rajratnapatil9/Adaptive-Headlight-system-for-Automobile-/Setup.JPG

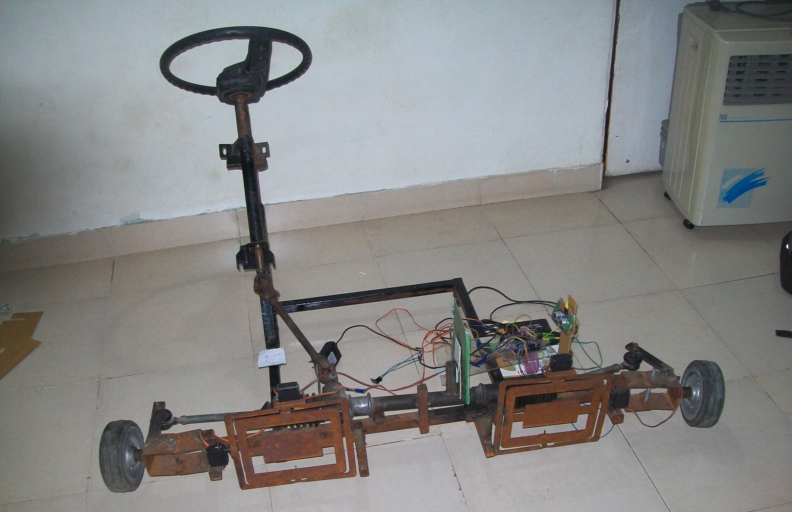
Setup.JPG
