rajratnapatil9/Adaptive-Headlight-system-for-Automobile-/Adaptive Headlight System for Automobiles.pdf

## BE PROJECT

## ADAPTIVE HEADLIGHT SYSTEM FOR AUTOMOBILES

By
RAJRATNA PATIL | (B120310951)
OMKAR PAWAR | (B120310958)
ABHISHEK PATHAK | (B120310958)

# Need of Project

- In 2014 out of 6,98,451 people from accident 4,882 people dead.
- Night accidents-Poor Road visibility on Curved path - 25%
Poor Road visibility due to slope of driving terrain - 30% Other reasons – 45%

## AIM OF THE PROJECT

## This project is aimed at developing an adaptive headlight system for automobiles that automates the movement of headlights

without manual switching.

# Project objectives

- To enhance existing functionality of headlights.
- Improve visibility on turns.
- Decrease number of night accidents.

## - Increase safety for drivers and pedestrians

HORIZONTAL
SWIVELING
(Yawing OF HEADLIGHT)

1] Horizontal Swiveling Is Used To
Turn The Headlight In Horizontal Plane.

2] It Rotates In The Direction Proportionate To The Wheel While Taking Turn.

1] Vertical Swiveling Is Used To Compensate The Pitching Of Car ,During Driving Through Steep Slope.

2] It Helps To Focus The Light At The Required Path.

VERTICAL
SWIVELING
(Pitching OF HEADLIGHT)

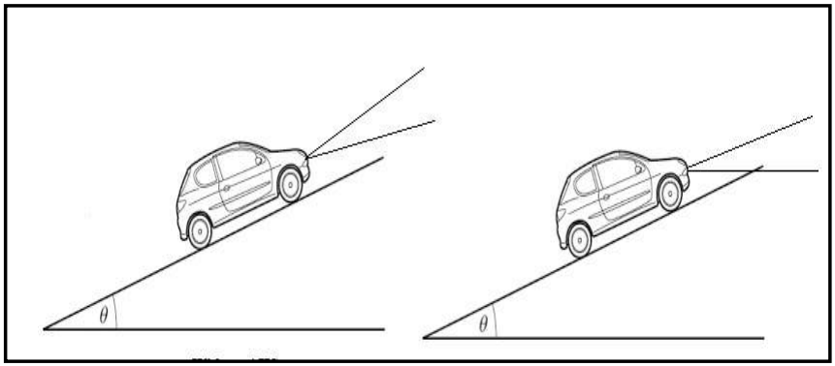
[picture p2: figure]
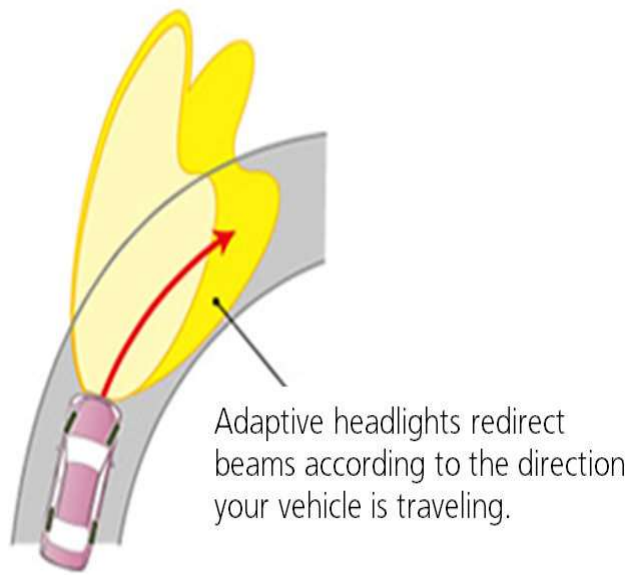
[picture p3: figure]

Without AHS | With AHS

# LOCK TO LOCK POSITION

### Center to Right/Left – 1.5 turns

### (540 degrees of steering wheel motion)

### Lock to Lock (Extreme Right to Extreme Left)

### 3turns (1080 degrees of steering wheel motion)

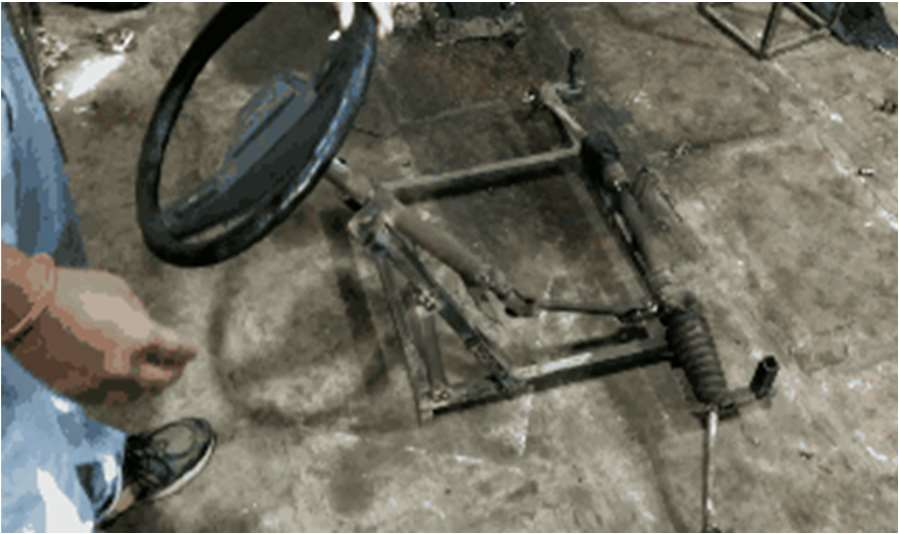
[picture p4: figure]

### Center to Right/ Left caster wheel

Angle- 45 degrees

### Lock to lock caster wheel Angle- 90 degrees

# Parts of Adaptive Headlight System

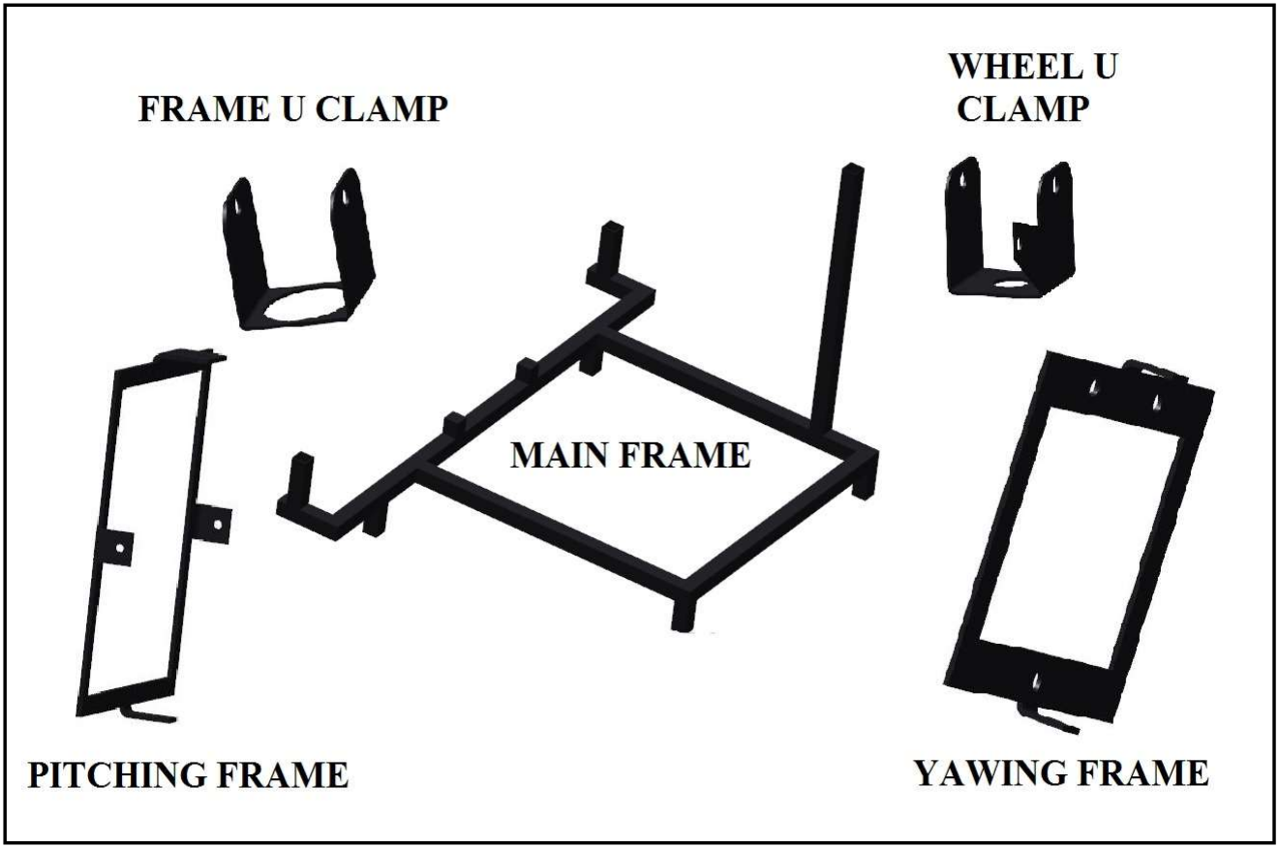
[picture p5: figure]

## CALCULATIONS

- The steering wheel has to rotate THREE complete revolutions
to move the caster wheel from lock-to-lock position . Thus 3 x 360 = 1080 degrees to move from lock-to-lock position

Thus 1.5 x 360 = 540 degrees to move from Center to Right/ Left position

Center to Right/ Left caster wheel Angle- 45 degrees
Therefore

S.R = 540/45 = 12:1

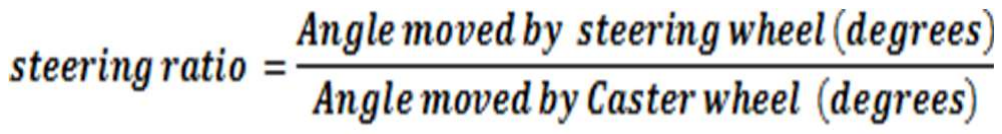
[picture p6: figure]

Specifications of rack and pinion assembly –

Number of teeth on rack = 27
Number of teeth on pinion = 18
Module = 1.5 mm
Pressure angle = 20 degrees Rack length = 127 mm

## CALCULATIONS

Parameter | Calculated Value
Area of Pitching Frame | (20.5 x 24.5) – (17.8 x 21.8) = 114.21 cm²
Area of Yawing Frame | {[(21 x 17.5) – (17 x 13.5)] + (2 x 2.5 x 2.1) + (12 x 6.5)} = 226.5 cm²
Total Area | 114.21 + 226.5 = 340.71 cm²
Total Volume | 340.71 x 0.2 = 68.142 cm³
Mass of Pitching and Yawing Frame | 7.85 x 68.142 = 511.065 gram
Total mass | 511.065 + 55 = approx 566 gram
Moment | (566 x sin20⁰ ) x (10.25) = 1984.22 gram-cm
Actual moment | 1984.22 x 1.5 = 2976.344 gram-cm
- Selecting motor such that Restoring Torque > Moment
As 9.40 kg-cm > 2.97 kg-cm
Therefore ,we selected Motor MG995 as it is best suited for our project.

# Manufacturing Stages

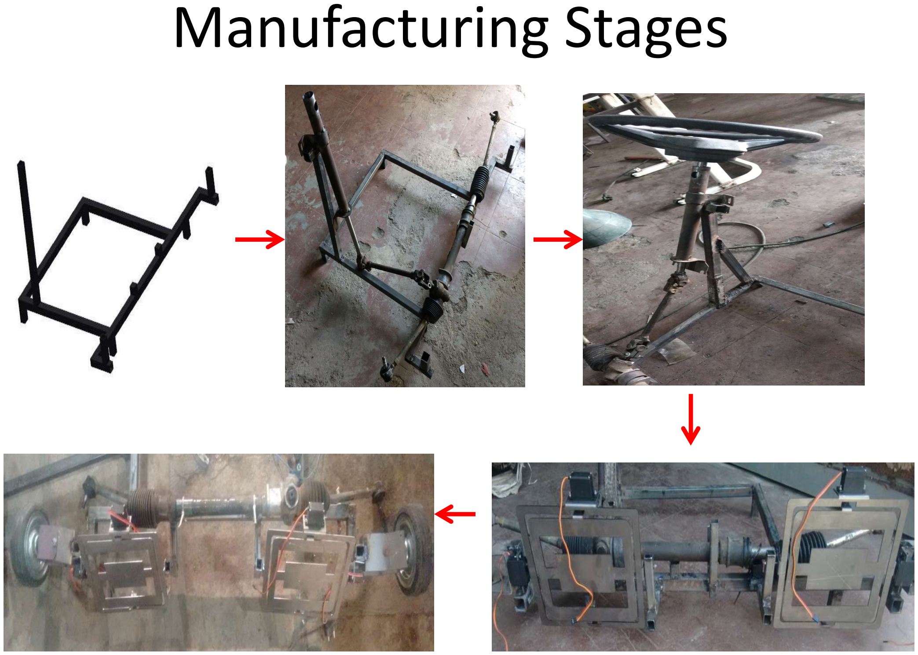
[picture p7: page 10]

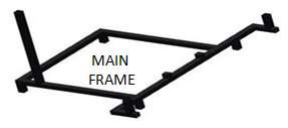
[picture p8: figure]

Main Frame

- Dimensions- 900 x 600 x 525 mm³
- Material- M.S (25 x 25 mm²
) • | Manufacturing processes- | Saw-cutting
- Electric-arc Welding(230 V)

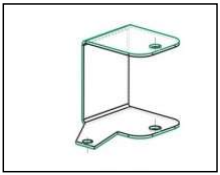
[picture p9: figure]

Wheel U-Clamp

- Dimensions- 68 X 60 X 64 mm³
- Material- M.S
- | Manufacturing processes- | Laser-cutting
- Bending
- Drilling

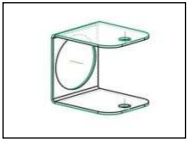
[picture p10: figure]

Frame U-Clamp

- Dimensions- 68 X 60 X 64 mm³
- Material- M.S
- | Manufacturing processes- | Laser-cutting
- Bending
- Drilling

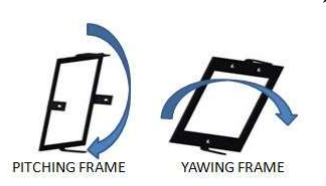
[picture p11: figure]

Pitching frame • | Dimensions- 205 x 245 x 32 • | Material- M.S • | Manufacturing processes- | Laser-cutting Bending

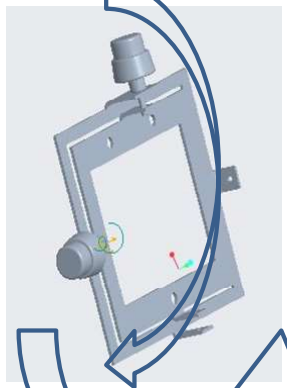
[picture p12: figure]

Yawing frame • | Dimensions- 210 x 175 x 27 • | Material- M.S • | Manufacturing processes- Laser-cutting Bending

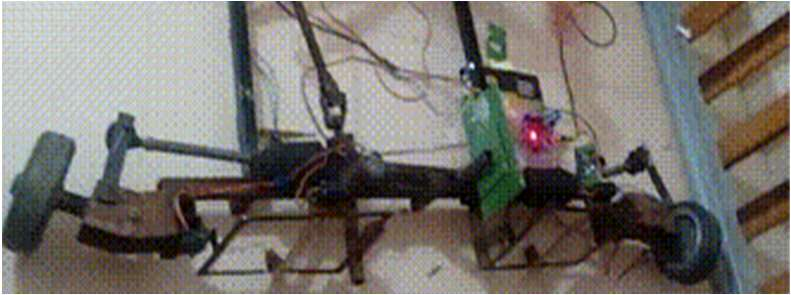
[picture p13: figure]
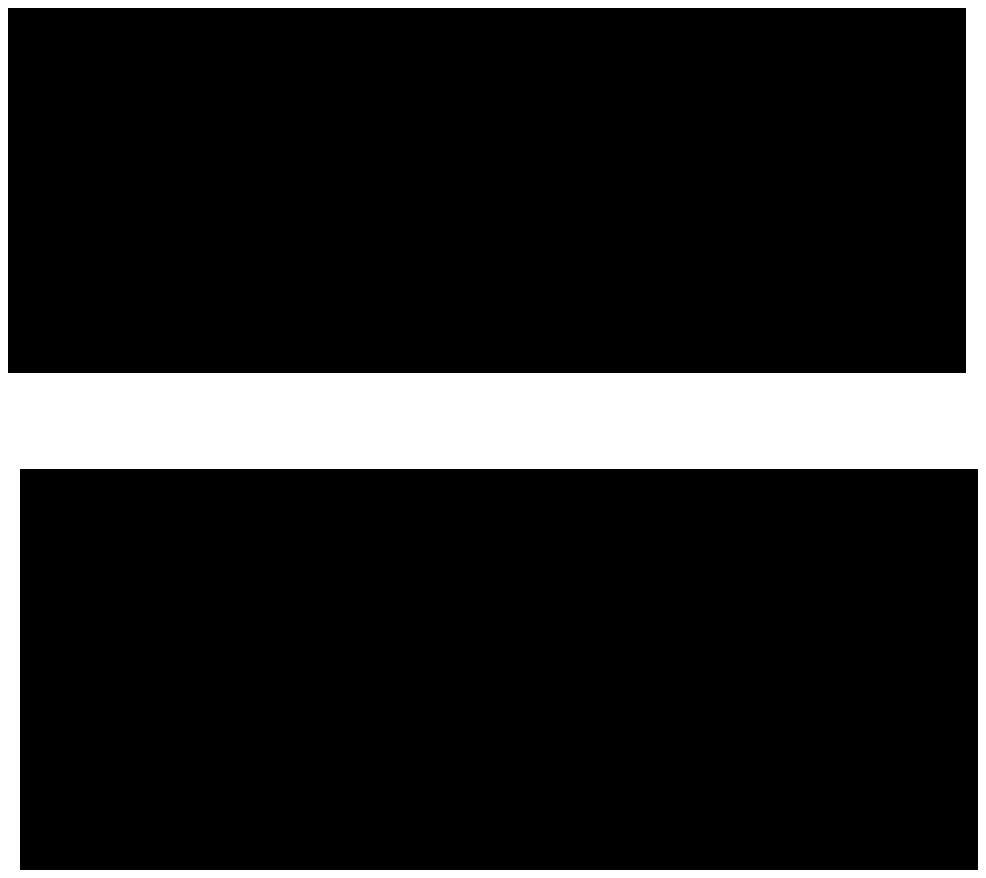
[picture p14: page 13]

## STEERING WHEEL &

STEERING COLUMN ASSEMBLY.

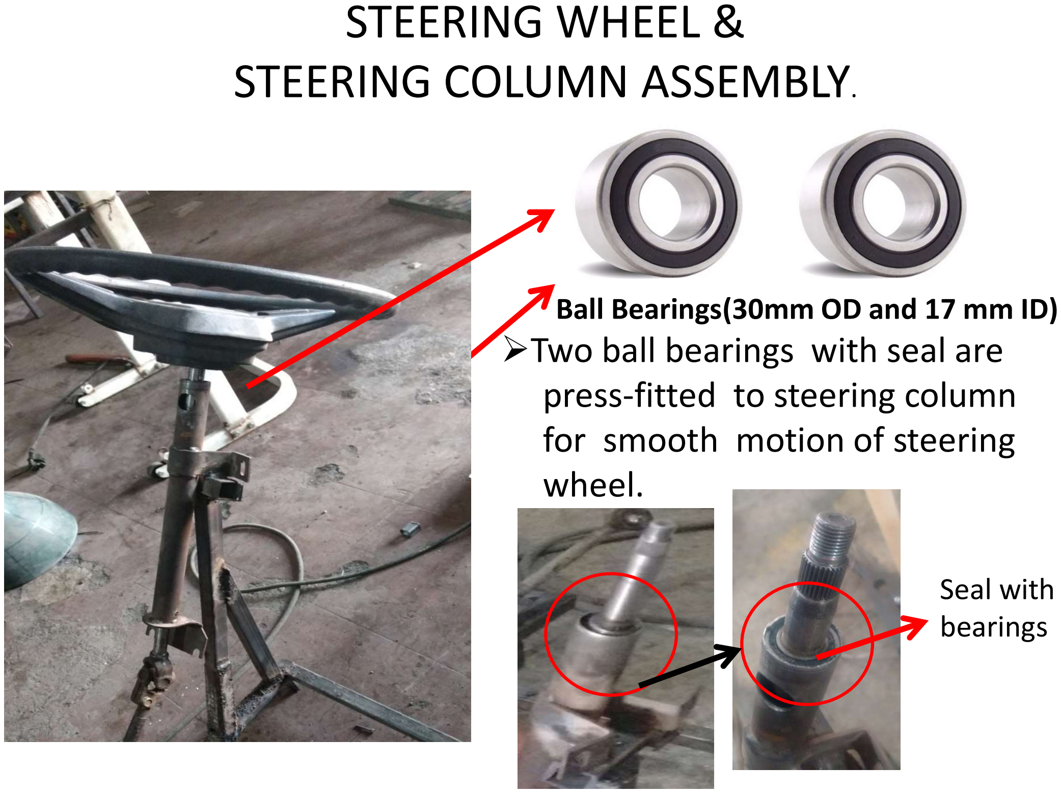
[picture p15: page 14]

Ball Bearings(30mm OD and 17 mm ID)

### Two ball bearings with seal are press-fitted to steering column for smooth motion of steering

wheel.

Seal with
bearings

# Procured Parts

Caster Wheel

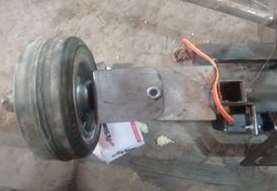
[picture p16: figure]

Dimensions

### 15 cm Diameter 10 cm axle length

- 3 cm axle diameter

Rack and Pinion Mechanism

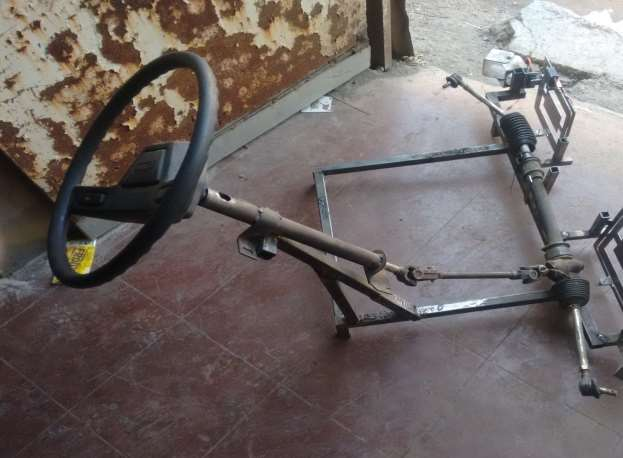
[picture p17: figure]

Specifications | Dimensions
Number of teeth on rack | 27
Number of teeth on pinion | 18
Module | 1.5 mm
Pressure angle | 20 ⁰
Rack length | 127 mm

Wheel U Clamp and Frame U Clamp with Caster Wheel

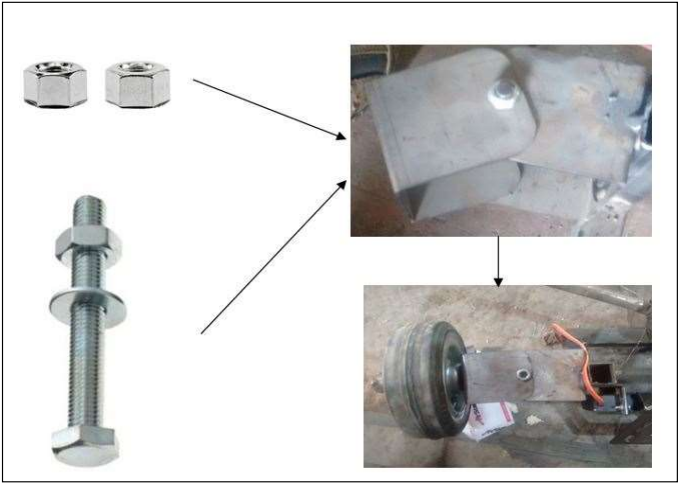
[picture p18: figure]

### Fastening Servo Frame

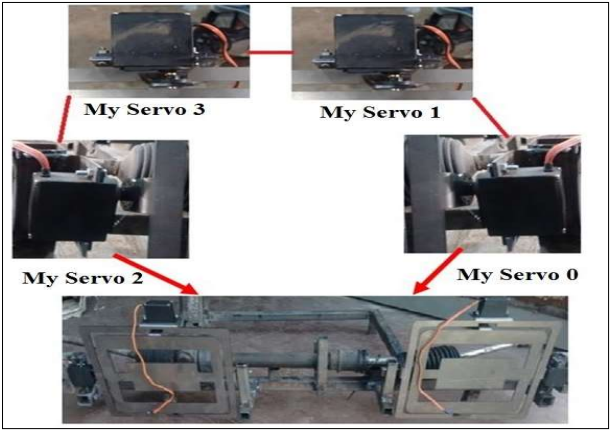
[picture p19: figure]

## BILL OF MATERIAL(BOM)

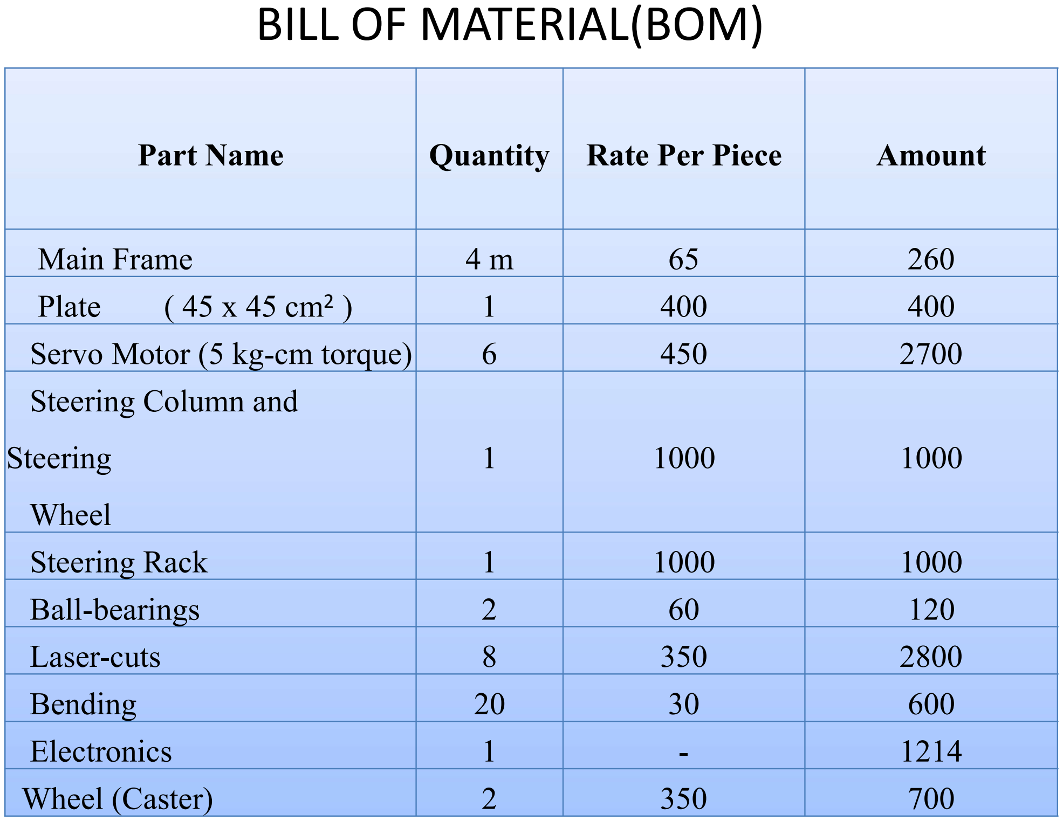
[picture p20: page 18]

Part Name | Quantity | Rate Per Piece | Amount
Main Frame | 4 m | 65 | 260
Plate ( 45 x 45 cm² ) | 1 | 400 | 400
Servo Motor (5 kg-cm torque) | 6 | 450 | 2700
Steering Column and Steering Wheel | 1 | 1000 | 1000
Steering Rack | 1 | 1000 | 1000
Ball-bearings | 2 | 60 | 120
Laser-cuts | 8 | 350 | 2800
Bending | 20 | 30 | 600
Electronics | 1 | - | 1214
Wheel (Caster) | 2 | 350 | 700

## SENSORS USED

1. Ultrasonic Sensor. 2. Accelerometer.

The Ultrasonic sensor is been used to sense-
- Distance moved by the caster wheel .

It is used as an input to Arduino .
It sends waves of particular frequency and when wave collides on nearest object it reflect back
Distance is calculated from the given formula
L = V x T

### 1. It works on +5 volts 2. Output is DC 3. Range is 2 to 450cm 4. Static current < 2mA 5. Sensor used is HC-SR04

## Ultrasonic sensor

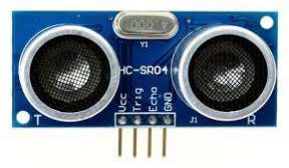
[picture p21: figure]

## Accelerometer sensor

This sensor is used –
- To identify the pitching (motion of the frame structure in vertical plane)
- It is used to determine vibration ,shock in 2 or 3 dimensions.
- The sensor is a polysilicon surface micro machined structure built on top of a silicon wafer.
- It is a capacitive type accelerometer.
- It gives output in analog form thus needs ADC, before being processed by Arduino.
- Input - 5volts
- We have used ADXL335

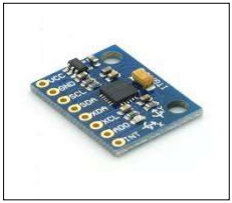
[picture p22: figure]

## BASIC ELECTRONIC STRUCTURE

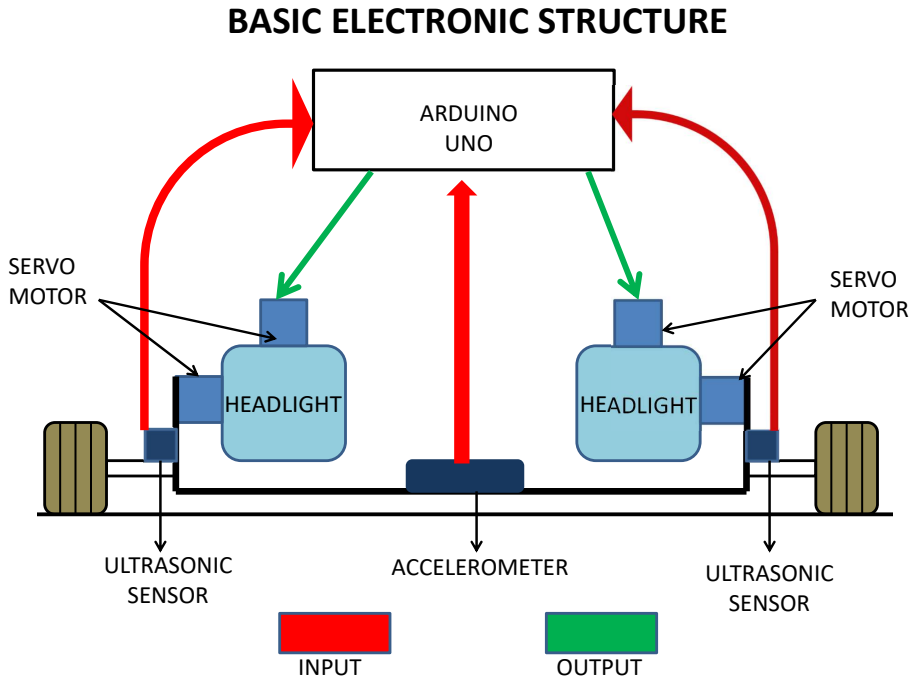
[picture p23: page 21]
ARDUINO UNO; ULTRASONIC SENSOR; HEADLIGHT; ACCELEROMETER; SERVO MOTOR; INPUT; OUTPUT

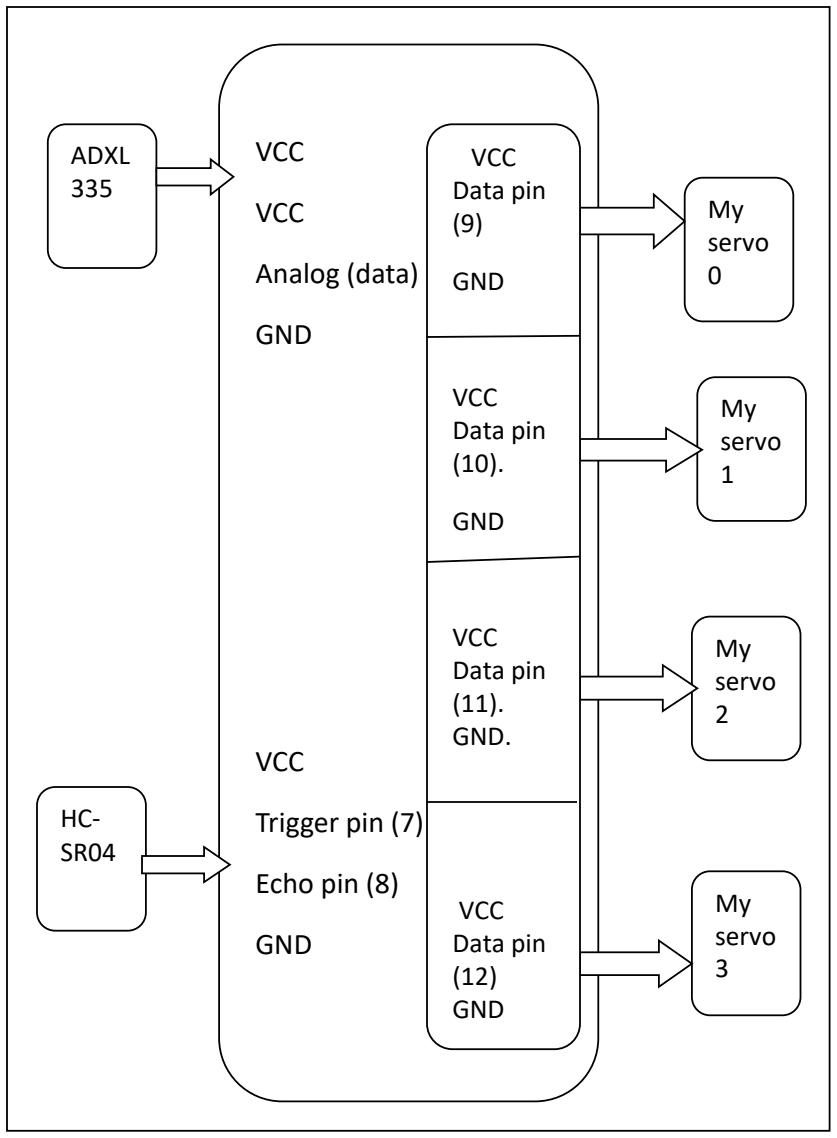
[picture p24: figure]
VCC; Analog (data); GND; Trigger pin (7); Echo pin (8); My servo 0; My servo 1; My servo 2; My servo 3; ADXL 335; VCC Data pin (9); VCC Data pin (10).; VCC Data pin (11). GND.; VCC Data pin (12) GND
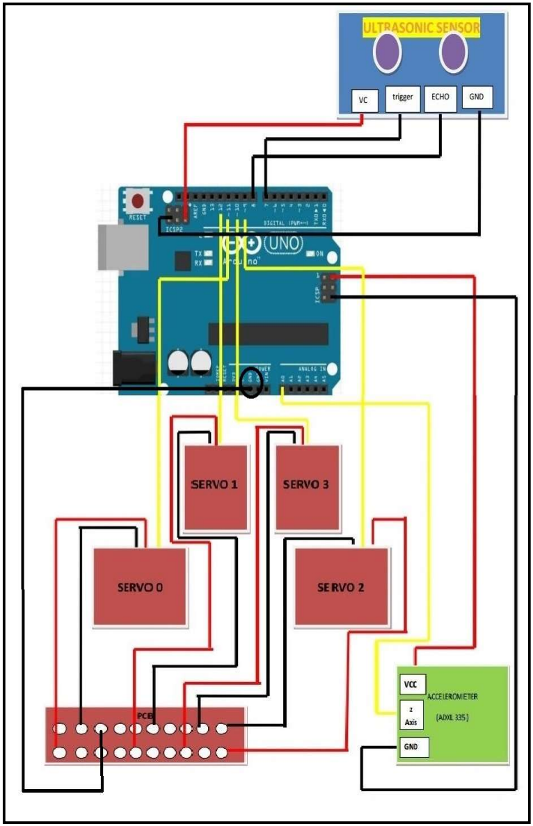
[picture p25: figure]
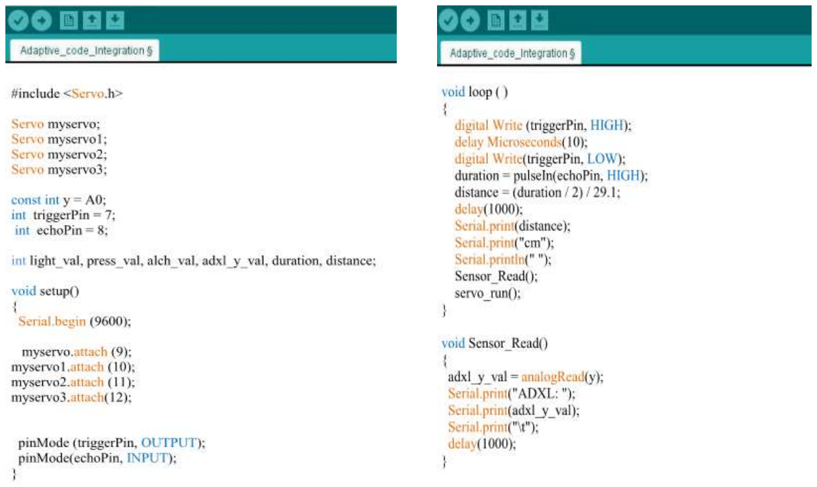
[picture p26: page 23]
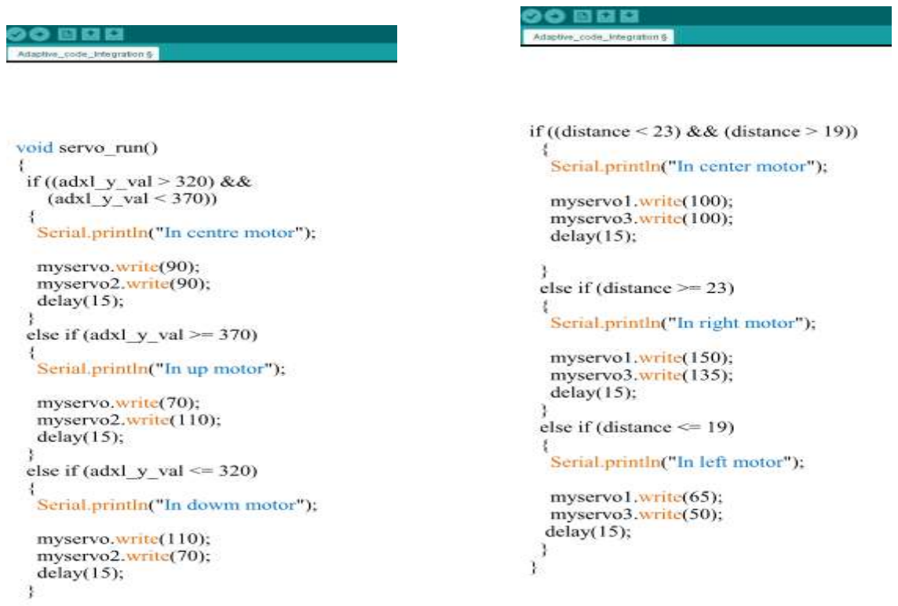
[picture p27: page 24]

Increase the height of the ultrasonic sensor by moving the sensor along positive Y axis.

- In order to solve this problem we could move the ultrasonic sensor along negative Z axis Best optimum solution selected:

TROUBLE SHOOTING

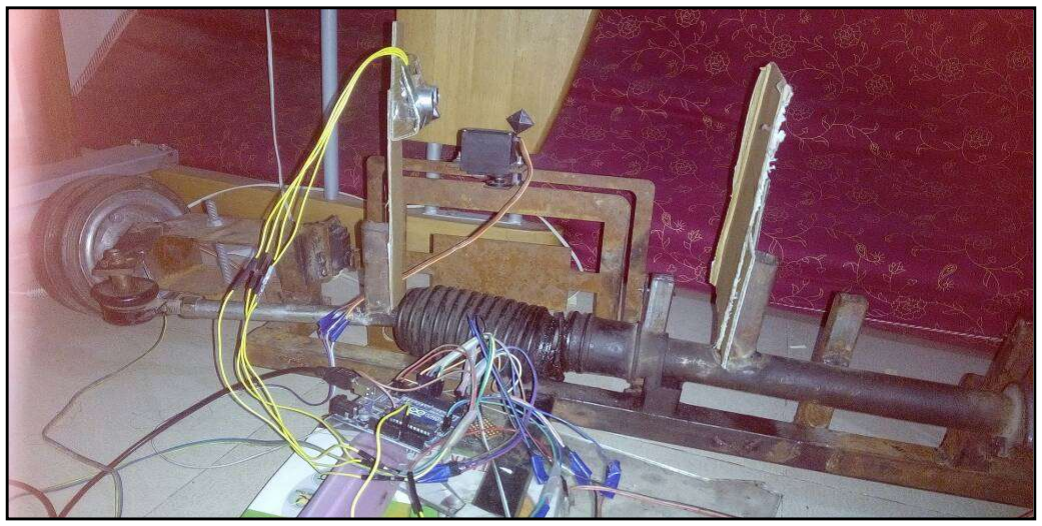
[picture p28: figure]

SR. NO. | Theoretical Value Of Outside Lock Angle In Degrees | Experiment Value Of Outside Lock Angle In Degrees | Accuracy
1 | 35 | 32 | 91.428%
2 | 35 | 34
3 | 35 | 31
SR. NO. | Theoretical Value Of Inside Lock Angle In Degrees | Experiment Value Of Inside Lock Angle In Degrees | Accuracy
1 | 45 | 44 | 97.77%
2 | 45 | 45
3 | 45 | 43

RESULT TABLE - YAWING FRAME

RESULT TABLE - PITCHING FRAME

SR. NO. | Actual Value In Degrees | Experiment Value In Degrees | Accuracy
1 | 20 | 18 | 88.33%
2 | 20 | 16
3 | 20 | 19

## Gantt Chart

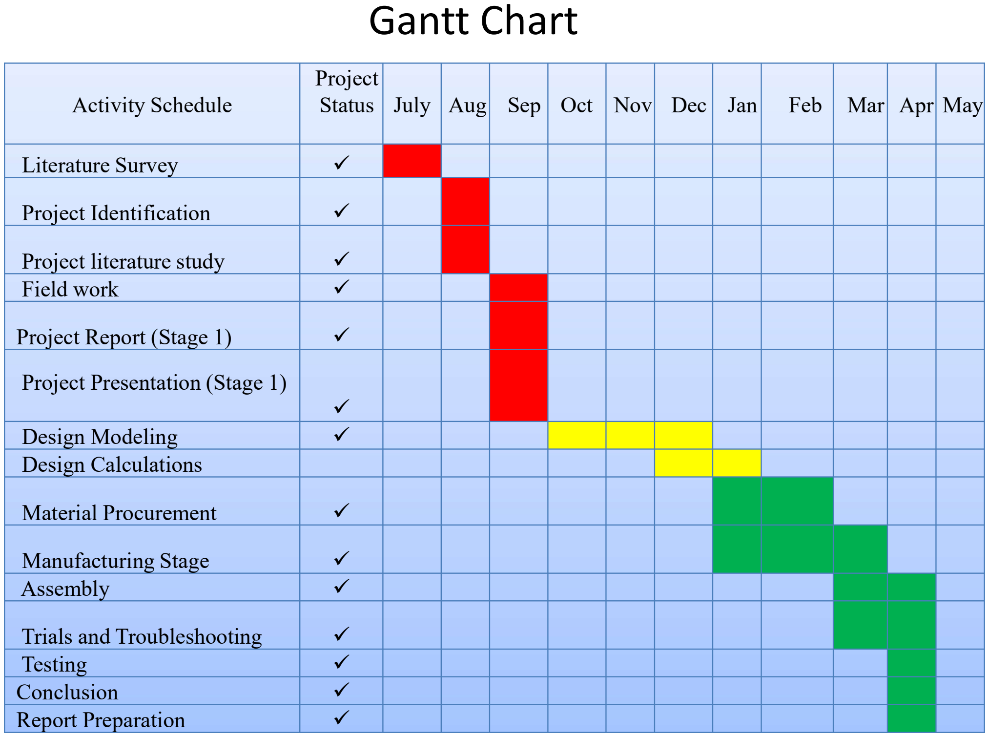
[picture p29: page 27]

Activity Schedule | Project Status | July | Aug | Sep | Oct | Nov | Dec | Jan | Feb | Mar | Apr | May
Literature Survey |
Project Identification |
Project literature study |
Field work |
Project Report (Stage 1) |
Project Presentation (Stage 1) |
Design Modeling |
Design Calculations
Material Procurement |
Manufacturing Stage |
Assembly |
Trials and Troubleshooting |
Testing |
Conclusion |
Report Preparation |

Considering functionality, adaptability, accuracy of adaptive headlight system-

- Objective of headlight motion according to vehicle dynamics (Pitching and Yawing of headlight) is achieved by mechanical and electronic coupling of Arduino UNO,
ultrasonic sensor, accelerometer (ADXL 335).
- The level of accuracy is optimized using several experimental tests for user comfort and convenience.
- It is concluded that with Adaptive headlight system, the number of night accidents will reduce reasonably and that the reaction time or response time of the system in range of milliseconds (15 to 30).

## CONCLUSION

## REFERENCES

[1] Vaishali D.Todkar and Mrs.M.R.Bachute, “Survey on Adaptive Front Light System” International Journal on Advanced Research (2016) , Volume 4, Issue 4.
[2] Meftah Hrairi and Anwar B.Abu Bakar ; "Development of an Adaptive
Headlamp Systems “ International Conference on Computer and Communication Engineering (ICCCE 2010), 11-13 May 2010, Kuala Lumpur, Malaysia.
[3] Snehal Parhad “Development Of Automotive Adaptive Front Lighting System” M.E (Electronics & Telecommunication Department), Mit College Of Engineering, Pune
[4] Shirsat Shashikant, Mechkul M.A. "Adaptive Front Light System “ IOSR Journal of Electronics and Communication Engineering (IOSR-JECE) e-ISSN: 2278-2834, p-ISSN: 2278-8735 (PP 05-09)
[5] Renton Ma "Automotive Adaptive Front-lighting System Reference Design" Texas Instrumentation-Reference design SPRUHP3 july-2013

# Thank you!
